nicholas-cortes10/emg-fatigue-monitor/docs/Images/angle_photo.PNG

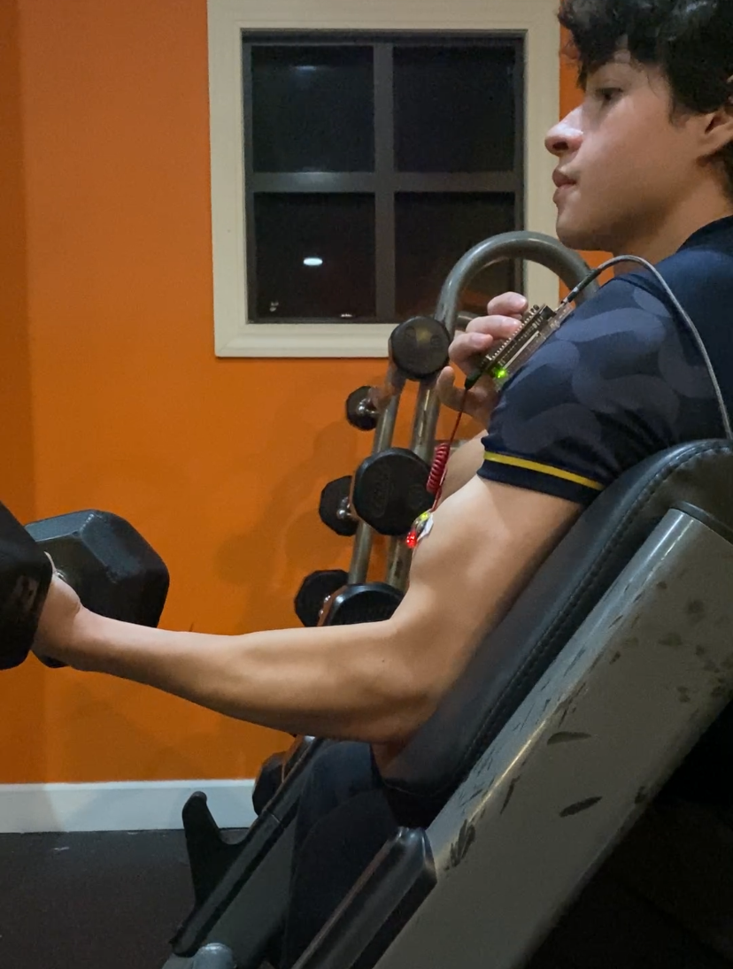
docs/Images/angle_photo.PNG
