nicholas-cortes10/emg-fatigue-monitor/data/raw/isometric_hold_01_15s_TEST.csv

value
8138
8123
8144
8172
8158
8182
8168
8166
8182
8161
8169
8159
8161
8166
8169
8200
8187
8193
8172
8193
8172
8159
8148
8126
8149
8166
8195
8195
8203
8175
8173
8202
8210
8229
8229
8205
8215
8175
8134
8125
8110
8150
8164
8173
8165
8148
8166
8182
8179
8202
8216
8217
8199
8198
8188
8180
8192
8178
8176
8181
8178
8160
8139
8142
8141
8158
8195
8199
8237
8239
8199
8187
8175
8156
8125
8143
8147
8160
8176
8202
8199
8181
8163
8175
8171
8160
8167
8206
8216
8202
8187
8178
8164
8150
8130
8160
8214
8199
8199
8198
8204
8197
8198
8164
8160
8168
8159
8136
8149
8147
8159
8162
8185
8182
8192
8161
8168
8160
8168
8179
8162
8172
8160
8170
8194
8160
8176
8146
8163
8176
8152
8157
8151
8174
8156
8184
8163
8175
8150
8167
8163
8176
8182
8159
8160
8150
8172
8177
8168
8164
8167
8168
8165
8178
8155
8164
8184
8170
8176
8163
8161
8147
8161
8185
8194
8187
8181
8160
8179
8146
8182
8169
8212
8204
8189
8199
8205
8202
8175
8130
8122
8030
8047
8076
8111
8152
8173
8173
8168
8155
8148
8154
8116
8147
8165
8154
8190
8181
8181
8217
8225
8205
8200
8178
8163
8198
8196
8201
8194
8186
8172
8209
8185
8200
8190
8190
8181
8175
8171
8160
8172
8147
8137
8137
8161
8150
8138
8149
8153
8142
8148
8149
8163
8153
8182
8159
8160
8167
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
