nicholas-cortes10/emg-fatigue-monitor/docs/Images/first_flex_test.png

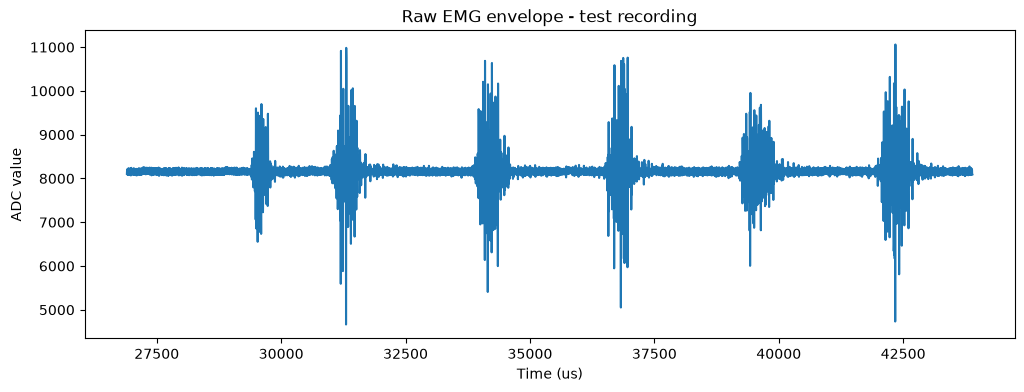
docs/Images/first_flex_test.png
