nicholas-cortes10/emg-fatigue-monitor/(commit log)

2026-09-17 Fix emg_logger.ino: restore missing INTERVAL_US/lastSample declarations
    [emg_logger.ino]
2026-11-11 first valid isometric hold recording (999 Hz, 90 s)
2026-11-11 Add bandpass and sliding-window median frequency analysis
    - check_window.py plots the start and end of the recording to choose the analysis window (3.0–61.5 s)
    - pipeline.py: mean removal, 4th-order zero-phase Butterworth bandpass (20–450 Hz), Welch PSD, median frequency over 5 s windows with 1 s steps, linear trend fit
    - Scripts save figures with the Agg backend because the Jupyter kernel hangs on this laptop
    - mf_trend_hold01.png: median frequency falls from ~70 Hz to ~52 Hz across the hold (pilot trial)
    - .gitignore: ignore scratch PNGs regenerated in analysis/
2026-11-11 Remove stale notebook cells
    Deleted cells that depended on pandas (blocked by Windows Application Control on this laptop) or on the old two-column test_log.csv format. Kept the numpy plot of isometric_hold_01.csv and added trimming of the possibly truncated first and last samples. Saved output predates the trim and will update once the kernel works.
2026-11-11 Log analysis session; add first flex test figure
    Lab notebook entry for the Nov 11 analysis session: window choice, bandpass, PSD with no visible 60 Hz peak (notch not applied), median frequency result and caveats. first_flex_test.png is the first raw test recording (six flexes), saved before deleting its notebook cell.
